janekc/led-tube/led-tube.kicad_sch

## KiCad design led-tube.kicad_sch (2023-11-02)

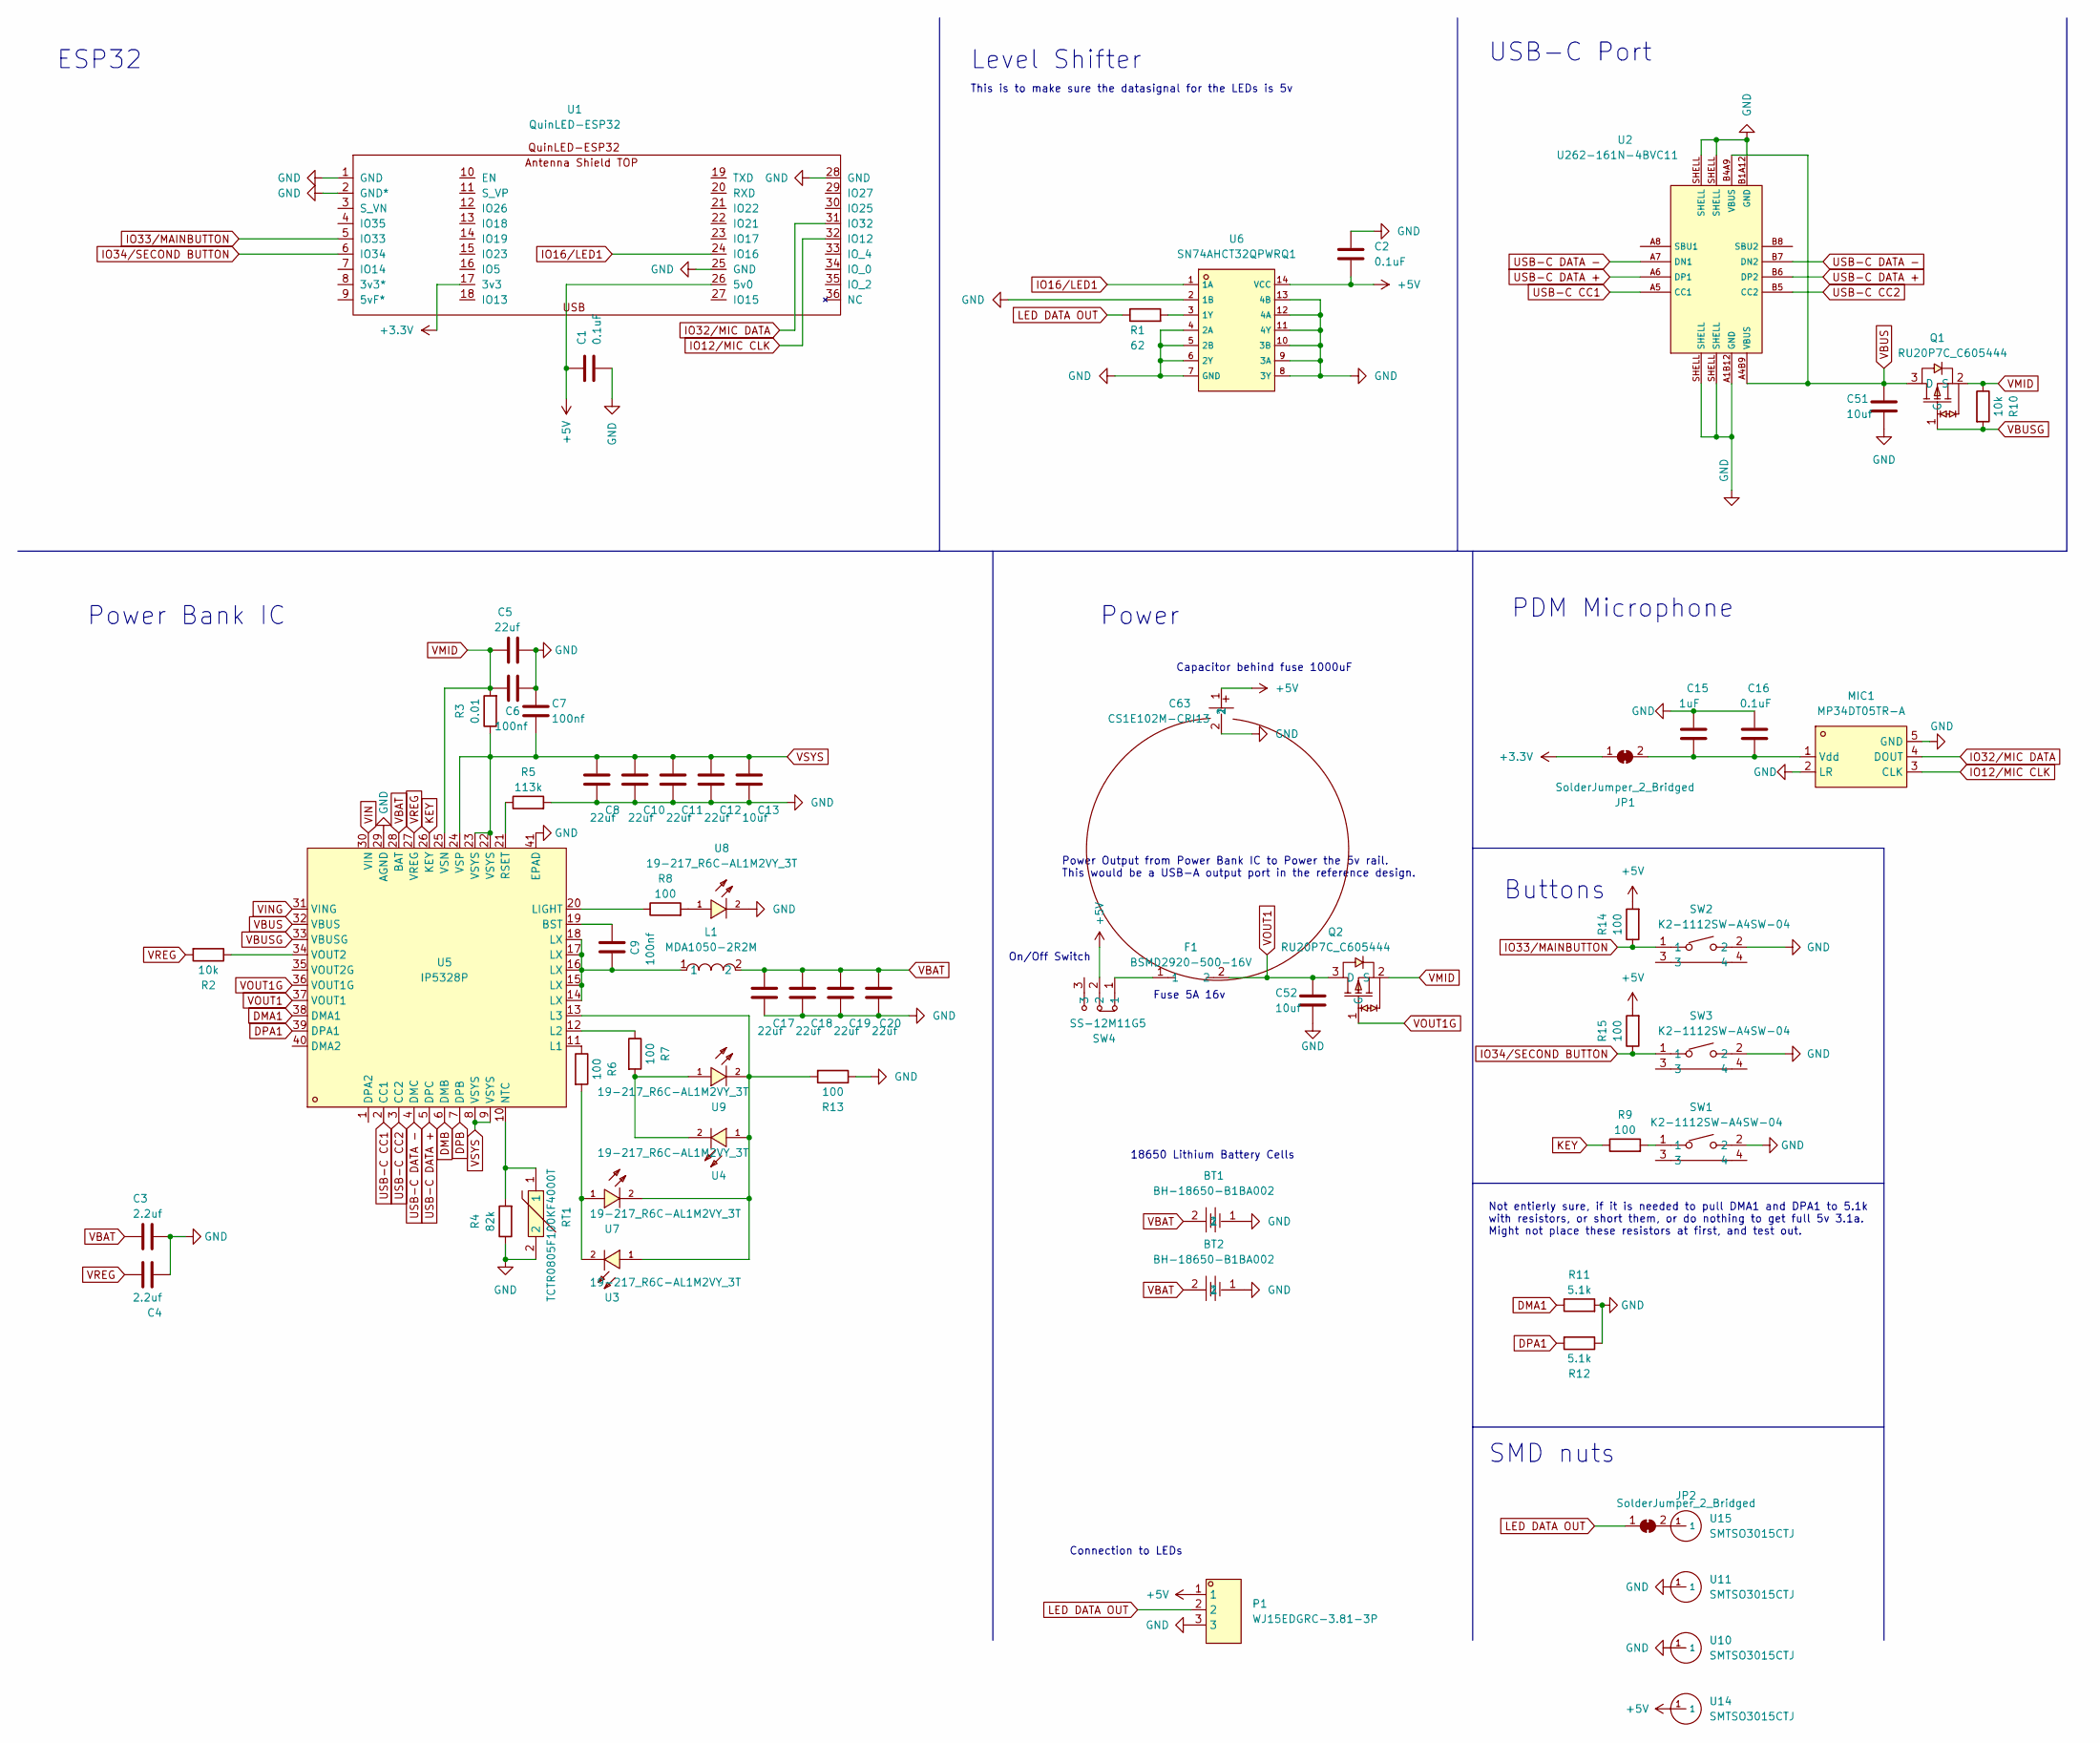
[picture p1: schematic led-tube.kicad_sch]

Parts:
BT1, BT2: BH-18650-B1BA002; BATTERY-SMD_18650-1S-L77.1-W20.7-1; LCSC Part C2988620
C1, C2, C16: 0.1uF; C_0603_1608Metric_Pad1.08x0.95mm_HandSolder
C3, C4: 2.2uf; C_0603_1608Metric_Pad1.08x0.95mm_HandSolder
C5, C8, C10, C11, C12, C17, C18, C19, C20: 22uf; C_0805_2012Metric_Pad1.18x1.45mm_HandSolder
C6, C7, C9: 100nf; C_0603_1608Metric_Pad1.08x0.95mm_HandSolder
C13, C51, C52: 10uf; C_0603_1608Metric_Pad1.08x0.95mm_HandSolder
C15: 1uF; C_0603_1608Metric_Pad1.08x0.95mm_HandSolder
C63: CS1E102M-CRI13; CAP-SMD_BD12.5-L13.0-W13.0-FD; LCSC Part C123705
F1: BSMD2920-500-16V; F2920; LCSC Part C910846
JP1, JP2: SolderJumper_2_Bridged; SolderJumper-2_P1.3mm_Bridged_RoundedPad1.0x1.5mm
L1: MDA1050-2R2M; IND-SMD_L11.0-W10.0; LCSC Part C2847559
MIC1: MP34DT05TR-A; MIC-SMD_5P-L3.0-W4.0-P0.85-BL; LCSC Part C2688664
P1: WJ15EDGRC-3.81-3P; CONN-TH_3P-P3.81_WJ15EDGRC-3.81-3P; LCSC Part C8406
Q1, Q2: RU20P7C_C605444; SOT-23-3_L2.9-W1.6-P1.90-LS2.8-BR; LCSC Part C605444
R1: 62; R_0603_1608Metric_Pad0.98x0.95mm_HandSolder
R2, R10: 10k; R_0603_1608Metric_Pad0.98x0.95mm_HandSolder
R3: 0.01; R_0603_1608Metric_Pad0.98x0.95mm_HandSolder
R4: 82k; R_0603_1608Metric_Pad0.98x0.95mm_HandSolder
R5: 113k; R_0603_1608Metric_Pad0.98x0.95mm_HandSolder
R6, R7, R8, R9, R13, R14, R15: 100; R_0603_1608Metric_Pad0.98x0.95mm_HandSolder
R11, R12: 5.1k; R_0603_1608Metric_Pad0.98x0.95mm_HandSolder
RT1: TCTR0805F100KF4000T; R0805; LCSC Part C525386
SW1, SW2, SW3: K2-1112SW-A4SW-04; KEY-TH_K2-1112SW-AXXW-XX; LCSC Part C223811
SW4: SS-12M11G5; SW-TH_XKB_SS-12M11XX; LCSC Part C2879839
U1: QuinLED-ESP32
U2: U262-161N-4BVC11; USB-3.1-SMD_U262-161N-4BVC11; LCSC # C319148
U3, U4, U7, U8, U9: 19-217_R6C-AL1M2VY_3T; LED0603-R-RD
U5: IP5328P; QFN-40_L6.0-W6.0-P0.50-BL-EP; LCSC Part C188809
U6: SN74AHCT32QPWRQ1; TSSOP-14_L5.0-W4.4-P0.65-LS6.5-BL; LCSC # C507218
U10, U11, U14, U15: SMTSO3015CTJ; SMTSO3030CTJ; LCSC # C2915308

Connections:
+3.3V: JP1.1 (A), U1.17 (3v3)
+5V: C1.1, C2.2, C63.1, P1.1, R14.2, R15.2, SW4.2, U1.26 (5v0), U6.14 (VCC), U14.1
DMA1: R11.1, U5.38 (DMA1)
DMB: U5.6 (DMB)
DPA1: R12.2, U5.39 (DPA1)
DPB: U5.7 (DPB)
GND: BT1.1, BT2.1, C1.2, C2.1, C3.1, C4.2, C5.2, C6.2, C7.1, C8.2, C10.2, C11.2, C12.2, C13.2, C15.1, C16.1, C17.2, C18.2, C19.2, C20.2, C51.2, C52.2, C63.2, MIC1.2 (LR), MIC1.5 (GND), P1.3, R4.1, R5.2, R11.2, R12.1, R13.1, RT1.2, SW1.2, SW2.2, SW3.2, U1.1 (GND), U1.2 (GND*), U1.25 (GND), U1.28 (GND), U2.A1B12 (GND), U2.B1A12 (GND), U2.SHELL, U5.29 (AGND), U5.41 (EPAD), U6.2 (1B), U6.4 (2A), U6.5 (2B), U6.6 (2Y), U6.7 (GND), U6.8 (3Y), U6.9 (3A), U6.10 (3B), U6.11 (4Y), U6.12 (4A), U6.13 (4B), U8.2 (C), U10.1, U11.1
IO12/MIC CLK: MIC1.3 (CLK), U1.32 (IO12)
IO16/LED1: U1.24 (IO16), U6.1 (1A)
IO32/MIC DATA: MIC1.4 (DOUT), U1.31 (IO32)
IO33/MAINBUTTON: R14.1, SW2.1, U1.5 (IO33)
IO34/SECOND BUTTON: R15.1, SW3.1, U1.6 (IO34)
KEY: R9.1, U5.26 (KEY)
LED DATA OUT: JP2.1 (A), P1.2, R1.1
unnamed: C9.1, L1.1, U5.14 (LX), U5.15 (LX), U5.16 (LX), U5.17 (LX), U5.18 (LX)
unnamed: C9.2, U5.19 (BST)
unnamed: C15.2, C16.2, JP1.2 (B), MIC1.1 (Vdd)
unnamed: F1.1, SW4.1
unnamed: JP2.2 (B), U15.1
unnamed: R1.2, U6.3 (1Y)
unnamed: R2.1, U5.34 (VOUT2)
unnamed: R4.2, RT1.1, U5.10 (NTC)
unnamed: R5.1, U5.21 (RSET)
unnamed: R6.1, U5.11 (L1)
unnamed: R6.2, U3.2 (C), U7.1 (A)
unnamed: R7.1, U5.12 (L2)
unnamed: R7.2, U4.2 (C), U9.1 (A)
unnamed: R8.1, U5.20 (LIGHT)
unnamed: R8.2, U8.1 (A)
unnamed: R9.2, SW1.1
unnamed: R13.2, U3.1 (A), U4.1 (A), U5.13 (L3), U7.2 (C), U9.2 (C)
USB-C CC1: U2.A5 (CC1), U5.2 (CC1)
USB-C CC2: U2.B5 (CC2), U5.3 (CC2)
USB-C DATA +: U2.A6 (DP1), U2.B6 (DP2), U5.5 (DPC)
USB-C DATA -: U2.A7 (DN1), U2.B7 (DN2), U5.4 (DMC)
VBAT: BT1.2, BT2.2, C3.2, C17.1, C18.1, C19.1, C20.1, L1.2, U5.28 (BAT)
VBUS: C51.1, Q1.3 (D), U2.A4B9 (VBUS), U2.B4A9 (VBUS), U5.32 (VBUS)
VBUSG: Q1.1 (G), R10.2, U5.33 (VBUSG)
VIN: U5.30 (VIN)
VING: U5.31 (VING)
VMID: C5.1, C6.1, Q1.2 (S), Q2.2 (S), R3.2, R10.1, U5.25 (VSN)
VOUT1: C52.1, F1.2, Q2.3 (D), U5.37 (VOUT1)
VOUT1G: Q2.1 (G), U5.36 (VOUT1G)
VREG: C4.1, R2.2, U5.27 (VREG)
VSYS: C7.2, C8.1, C10.1, C11.1, C12.1, C13.1, R3.1, U5.8 (VSYS), U5.9 (VSYS), U5.22 (VSYS), U5.23 (VSYS), U5.24 (VSP)

Notes on the sheet:
SMD nuts
18650 Lithium Battery Cells
Fuse 5A 16v
Capacitor behind fuse 1000uF
Power Bank IC
On/Off Switch
Power
PDM Microphone
USB-C Port
Buttons
Connection to LEDs
This is to make sure the datasignal for the LEDs is 5v
Level Shifter
Power Output from Power Bank IC to Power the 5v rail. This would be a USB-A output port in the reference design.
Not entierly sure, if it is needed to pull DMA1 and DPA1 to 5.1k with resistors, or short them, or do nothing to get full 5v 3.1a. Might not place these resistors at first, and test out.
ESP32
