janekc/led-tube/(commit log)

2023-10-02 add some links
    [BOM-led-tube.csv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]
2023-10-02 insert picture
2023-10-04 connect unconnected pieces, add micro usb for charging
    [led-tube.kicad_sch]
2023-11-02 place components, don't place leds but use ledstrips instead
    [led-tube.kicad_pcb, led-tube.kicad_sch]
2023-11-02 add opensource hardware logo
    [led-tube.kicad_pcb, led-tube.kicad_sch]
2023-11-02 generate gerber and drill files
    [BOM-led-tube.csv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]
